wrcrooks/rtlplayground-modchip/docs/architecture.html

# RTLPlayground mod chip — architecture

An RP2350 board on the SWTG024AS switch's T3/T5/T8 headers takes over management from the RTL8372's built-in 8051, which keeps only what has to run on it.

## Your network

Browser
RTLPlayground web UI, Graphs dashboard — HTTP :80, HTTPS :443

SNMP manager
SNMPv2c :161, MIB-2 + IF-MIB per port

Syslog / NTP / DNS / DHCP
servers the switch talks to

Peers
STP / RSTP, LACP, LLDP, IGMP

Switch
ports

management
traffic via the
CPU port

## SWTG024AS switch RTL8372

Switch core
4 × 2.5G copper + 2 × 10G SFP+, VLANs, L2/ACL tables, counters — forwarding never leaves the ASIC

8051 + bridge firmware (RTLPlayground feat/modchip)

- chip init, forwarding defaults at boot
- SerDes modes on link / SFP changes
- CPU-port DMA: tunnels frames both ways
- PHY (MDIO), SerDes, SFP EEPROM, SPI flash on request
- batched table and counter reads

Without the mod chip, or if it stops, the switch keeps forwarding as configured.

T5 · UART0
~1 Mbaud

COBS + CRC-16 frames
one request in flight:
REG / PHY / SDS / SFP / FLASH
TBL_READ, STAT_READ
+ RX/TX frames, link and SFP events

T3 · I²C 0x5C

register access (planned)
+ 3.3 V power in

T8 · GPIO46–49

spare GPIO + 3.3 V power in

## Mod chip RP2350A 16 MiB flash

RTLPlayground modules
compiled unchanged: CLI, JSON pages, VLAN/port/L2, STP, LACP, IGMP, LLDP, DNS, NTP, syslog

Register HAL
reg / PHY / SDS / flash calls become bridge requests

lwIP
IPv4, ARP, DHCP, TCP/UDP on a netif over the bridge; management VLAN

Web server
HTTP + HTTPS (mbedTLS, TLS 1.2, key made on the device)

SNMP agent
read-only v2c, switch ports as interfaces

Graphs
10 s sampler, 1 h history in RAM, live charts

### Board

LM66100 ideal diode from the switch's 3.3 V · reset driver to the switch · SWD pads (flashing, RTT console) · 3.3 V sense keeps pins isolated until the switch is powered

github.com/wrcrooks/rtlplayground-modchip Not yet tested on hardware
