wrcrooks/rtlplayground-modchip/docs/architecture.png

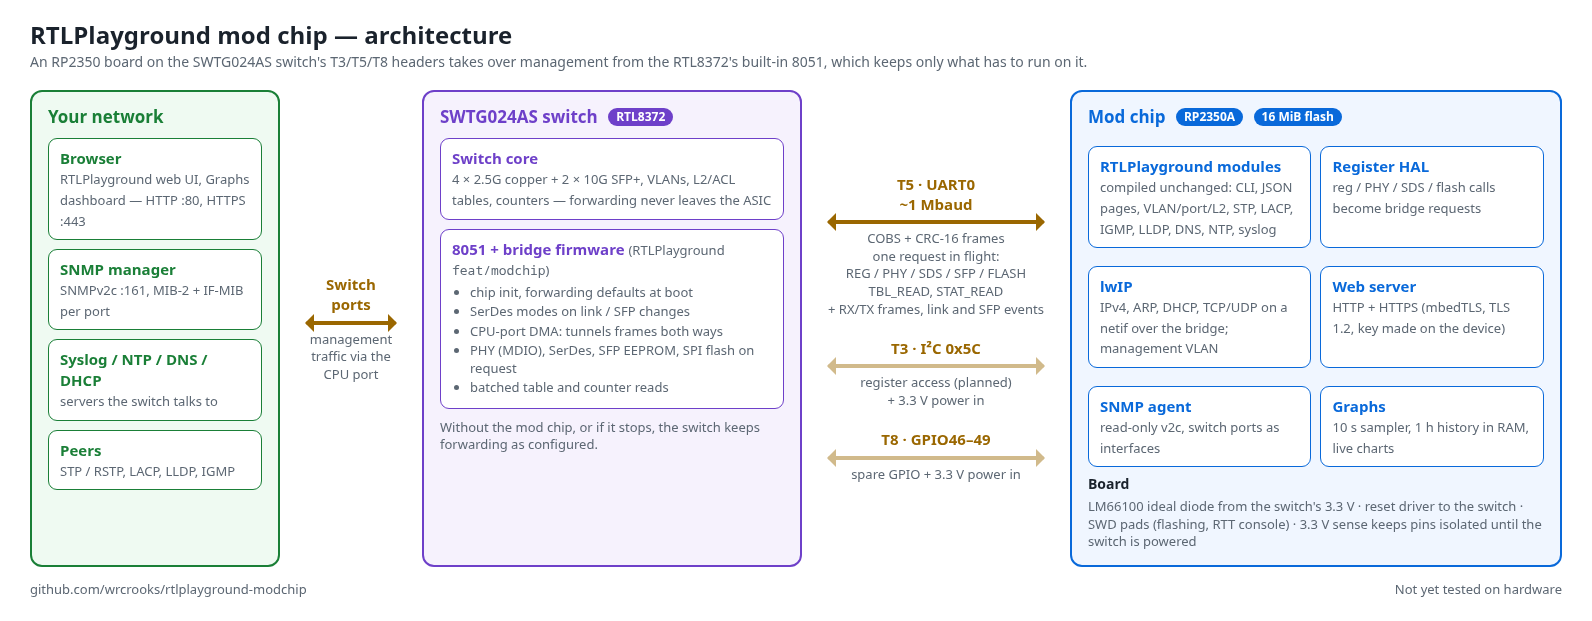
docs/architecture.png
