wrcrooks/rtlplayground-modchip/docs/pcb-3d.png

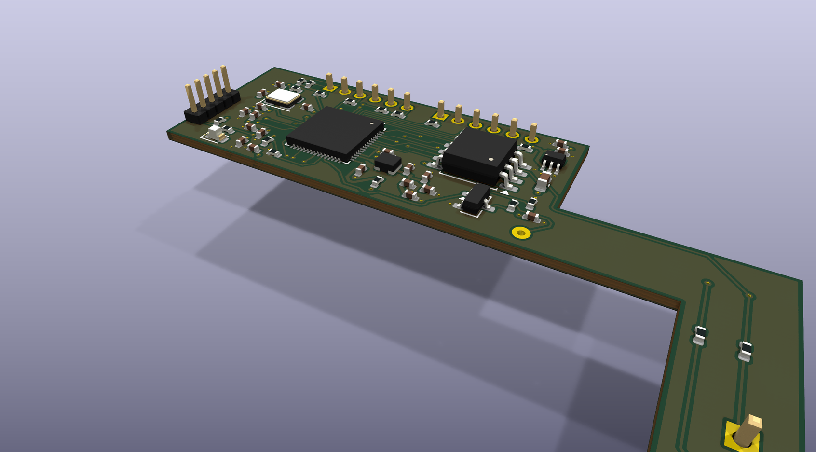
docs/pcb-3d.png
