wrcrooks/rtlplayground-modchip/hardware/overlay.jpg

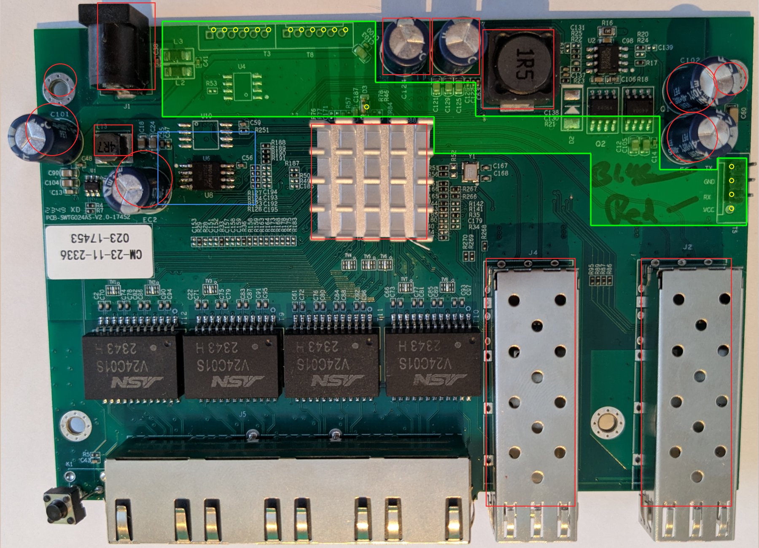
hardware/overlay.jpg
