wrcrooks/rtlplayground-modchip/hardware/production/bom.csv

Designator | Footprint | Quantity | Value | LCSC Part #
C1, C10, C11, C12, C19, C2, C3, C4, C5, C6, C7, C8, C9 | 0402 | 13 | 100n | C1525
C13, C14, C15, C16 | 0402 | 4 | 4.7u | C23733
C17, C18 | 0402 | 2 | 15p | C1548
C22 | 0603 | 1 | 10u | C19702
C24 | 0402 | 1 | 1u | C52923
D1 | 0603 | 1 | red | C2286
L1 | L_Murata_DFE201610P | 1 | 3.3uH | C42411119
Q1 | SOT-23 | 1 | 2N7002 | C8545
R10, R11, R12, R13, R14, R15, R16, R17, R18, R19 | 0402 | 10 | 100 | C25076
R20, R21 | 0402 | 2 | 4.7k | C25900
R22, R23, R24 | 0402 | 3 | 100k | C25741
R25, R6 | 0402 | 2 | 1k | C11702
R5 | 0402 | 1 | 33 | C25105
R8 | 0402 | 1 | 10k | C25744
R9 | 0402 | 1 | 330 | C25104
U1 | QFN-60-1EP_7x7mm_P0.4mm_EP3.4x3.4mm_ThermalVias | 1 | RP2350A | C42411118
U2 | SOT-363_SC-70-6 | 1 | LM66100 | C2869734
U5 | SOIC-8_5.3x5.3mm_P1.27mm | 1 | W25Q128JVSIQ | C97521
Y1 | Crystal_SMD_3225-4Pin_3.2x2.5mm | 1 | 12MHz | C20625731
