wrcrooks/rtlplayground-modchip/hardware/mechanical/modchip-no-headers.step

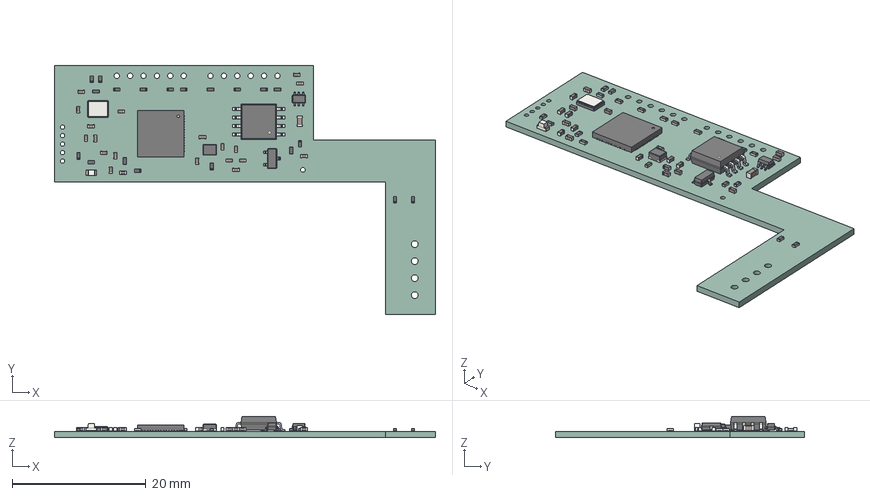
[picture p5: CAD file, 2026-10-25]
hardware/mechanical/modchip-no-headers.step
56.9 x 37.2 x 3.16 mm
C_0402_1005Metric x 20
C_0603_1608Metric
R_0402_1005Metric x 20
LED_0603_1608Metric
QFN-56-1EP_7x7mm_P0.4mm_EP3.2x3.2mm
SOT-23
L_Murata_DFE201610P
Crystal_SMD_3225-4Pin_3.2x2.5mm
SOIC-8_5.3x5.3mm_P1.27mm
SOT-363_SC-70-6
modchip_PCB
