wrcrooks/rtlplayground-modchip/hardware/modchip-outline.dxf

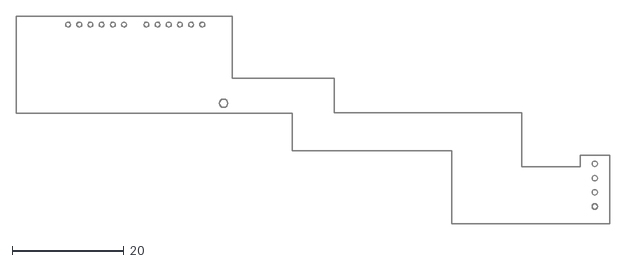
[picture p6: CAD file, 2026-10-22]
hardware/modchip-outline.dxf
106.2 x 37.2
