wrcrooks/rtlplayground-modchip/(list of files, cad)

Other CAD files:
hardware/mechanical/modchip-no-headers.stl
