wrcrooks/rtlplayground-modchip/hardware/modchip.kicad_pcb

## KiCad design hardware/modchip.kicad_pcb (2026-10-25)

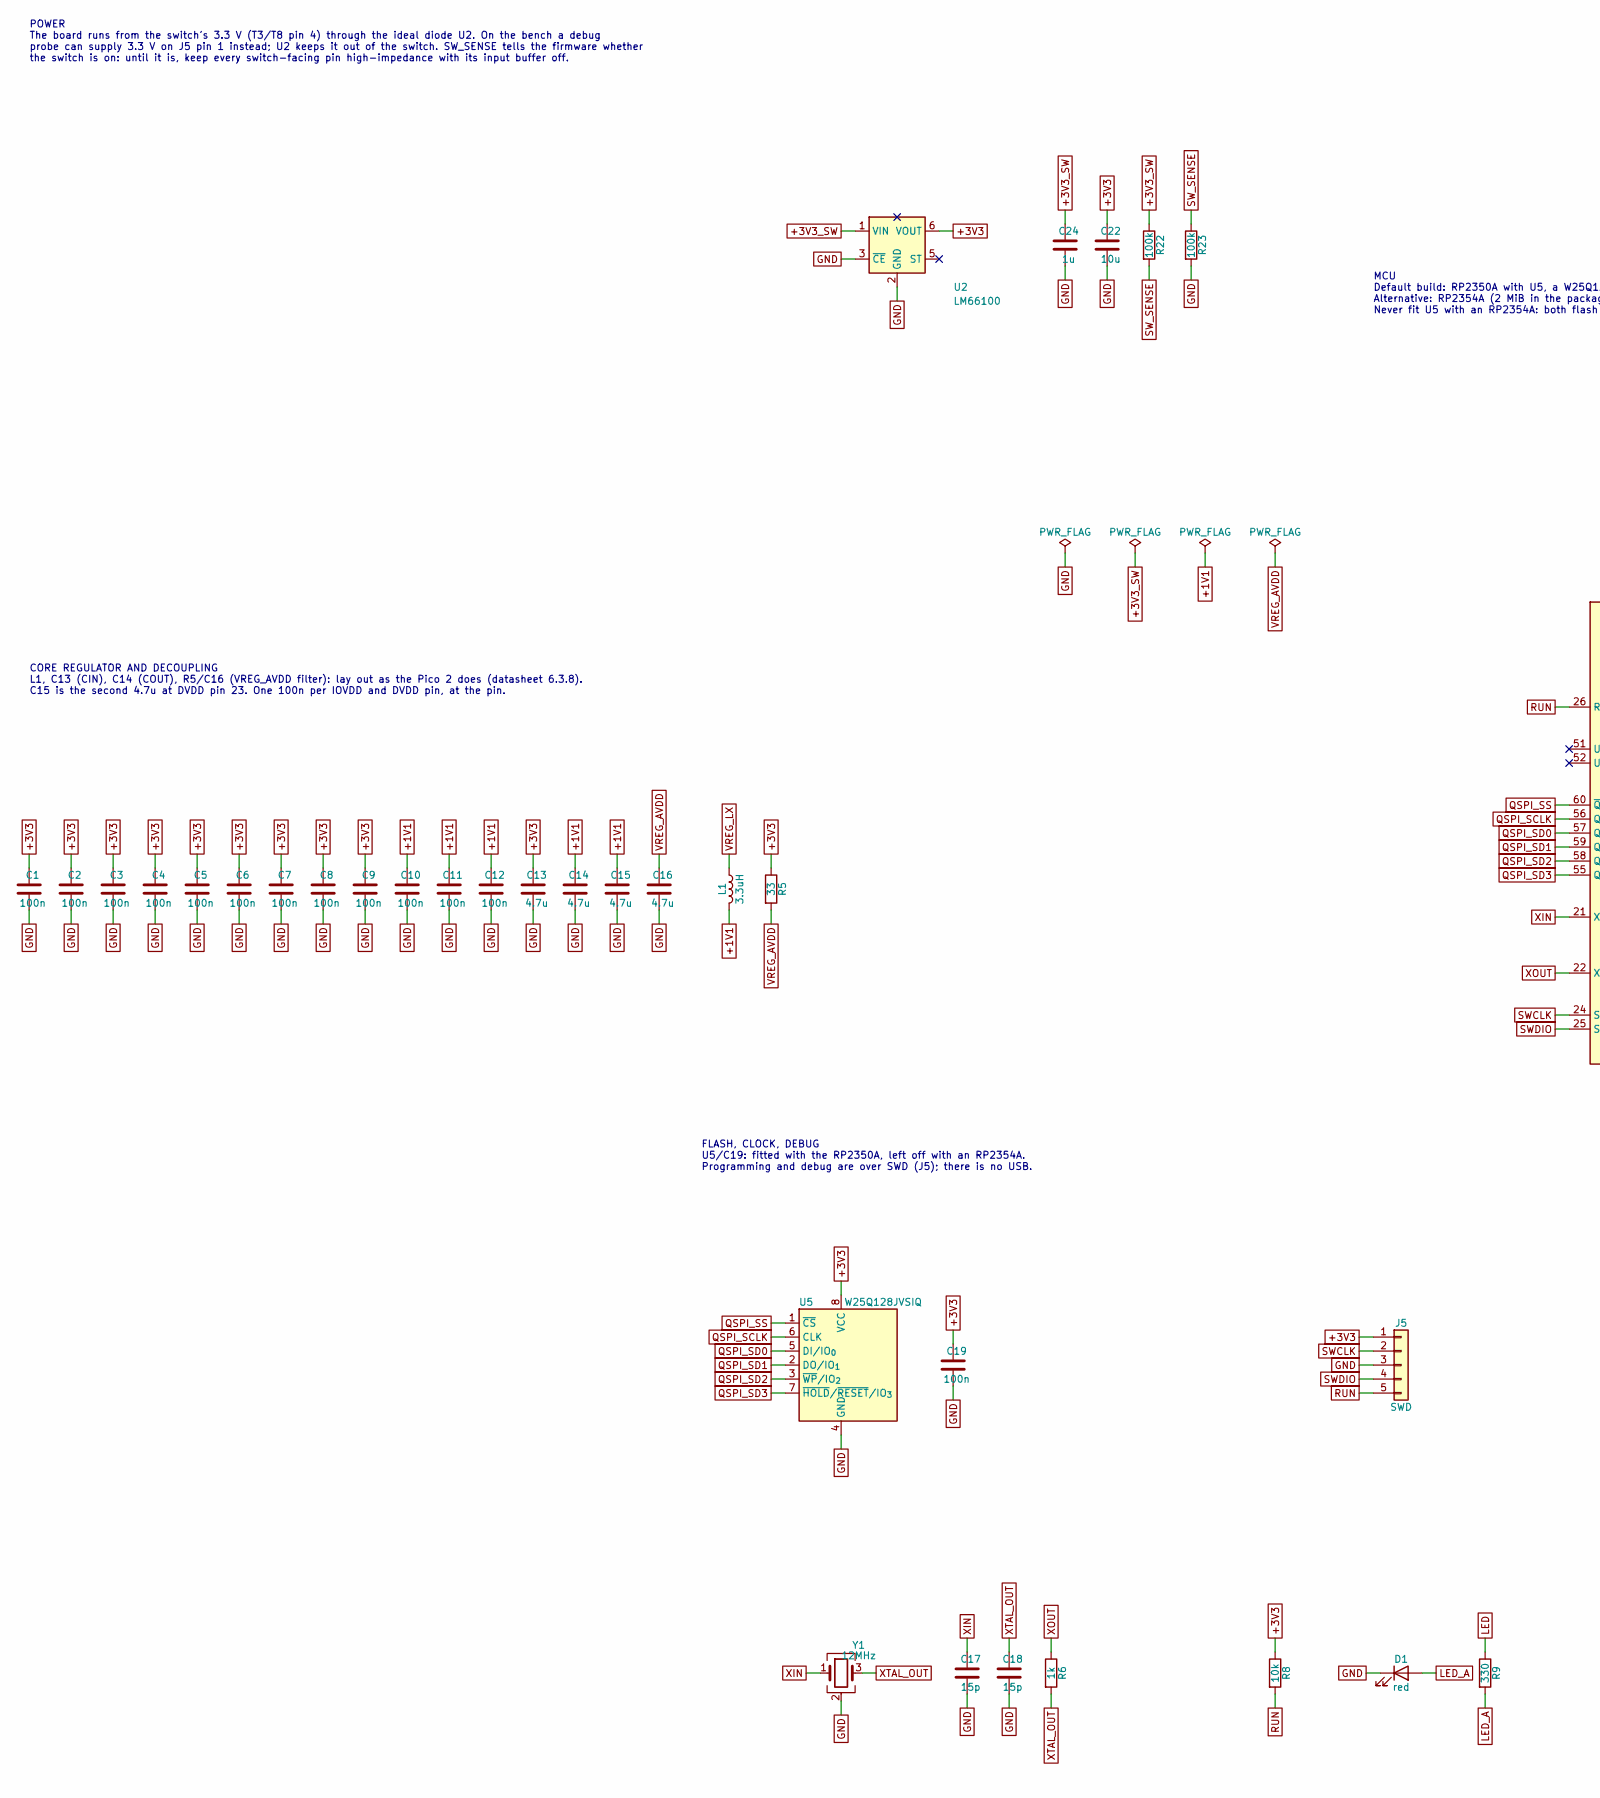
[picture p8: schematic modchip.kicad_sch, RTLPlayground mod chip (RP2350), part in row 1, column 1]

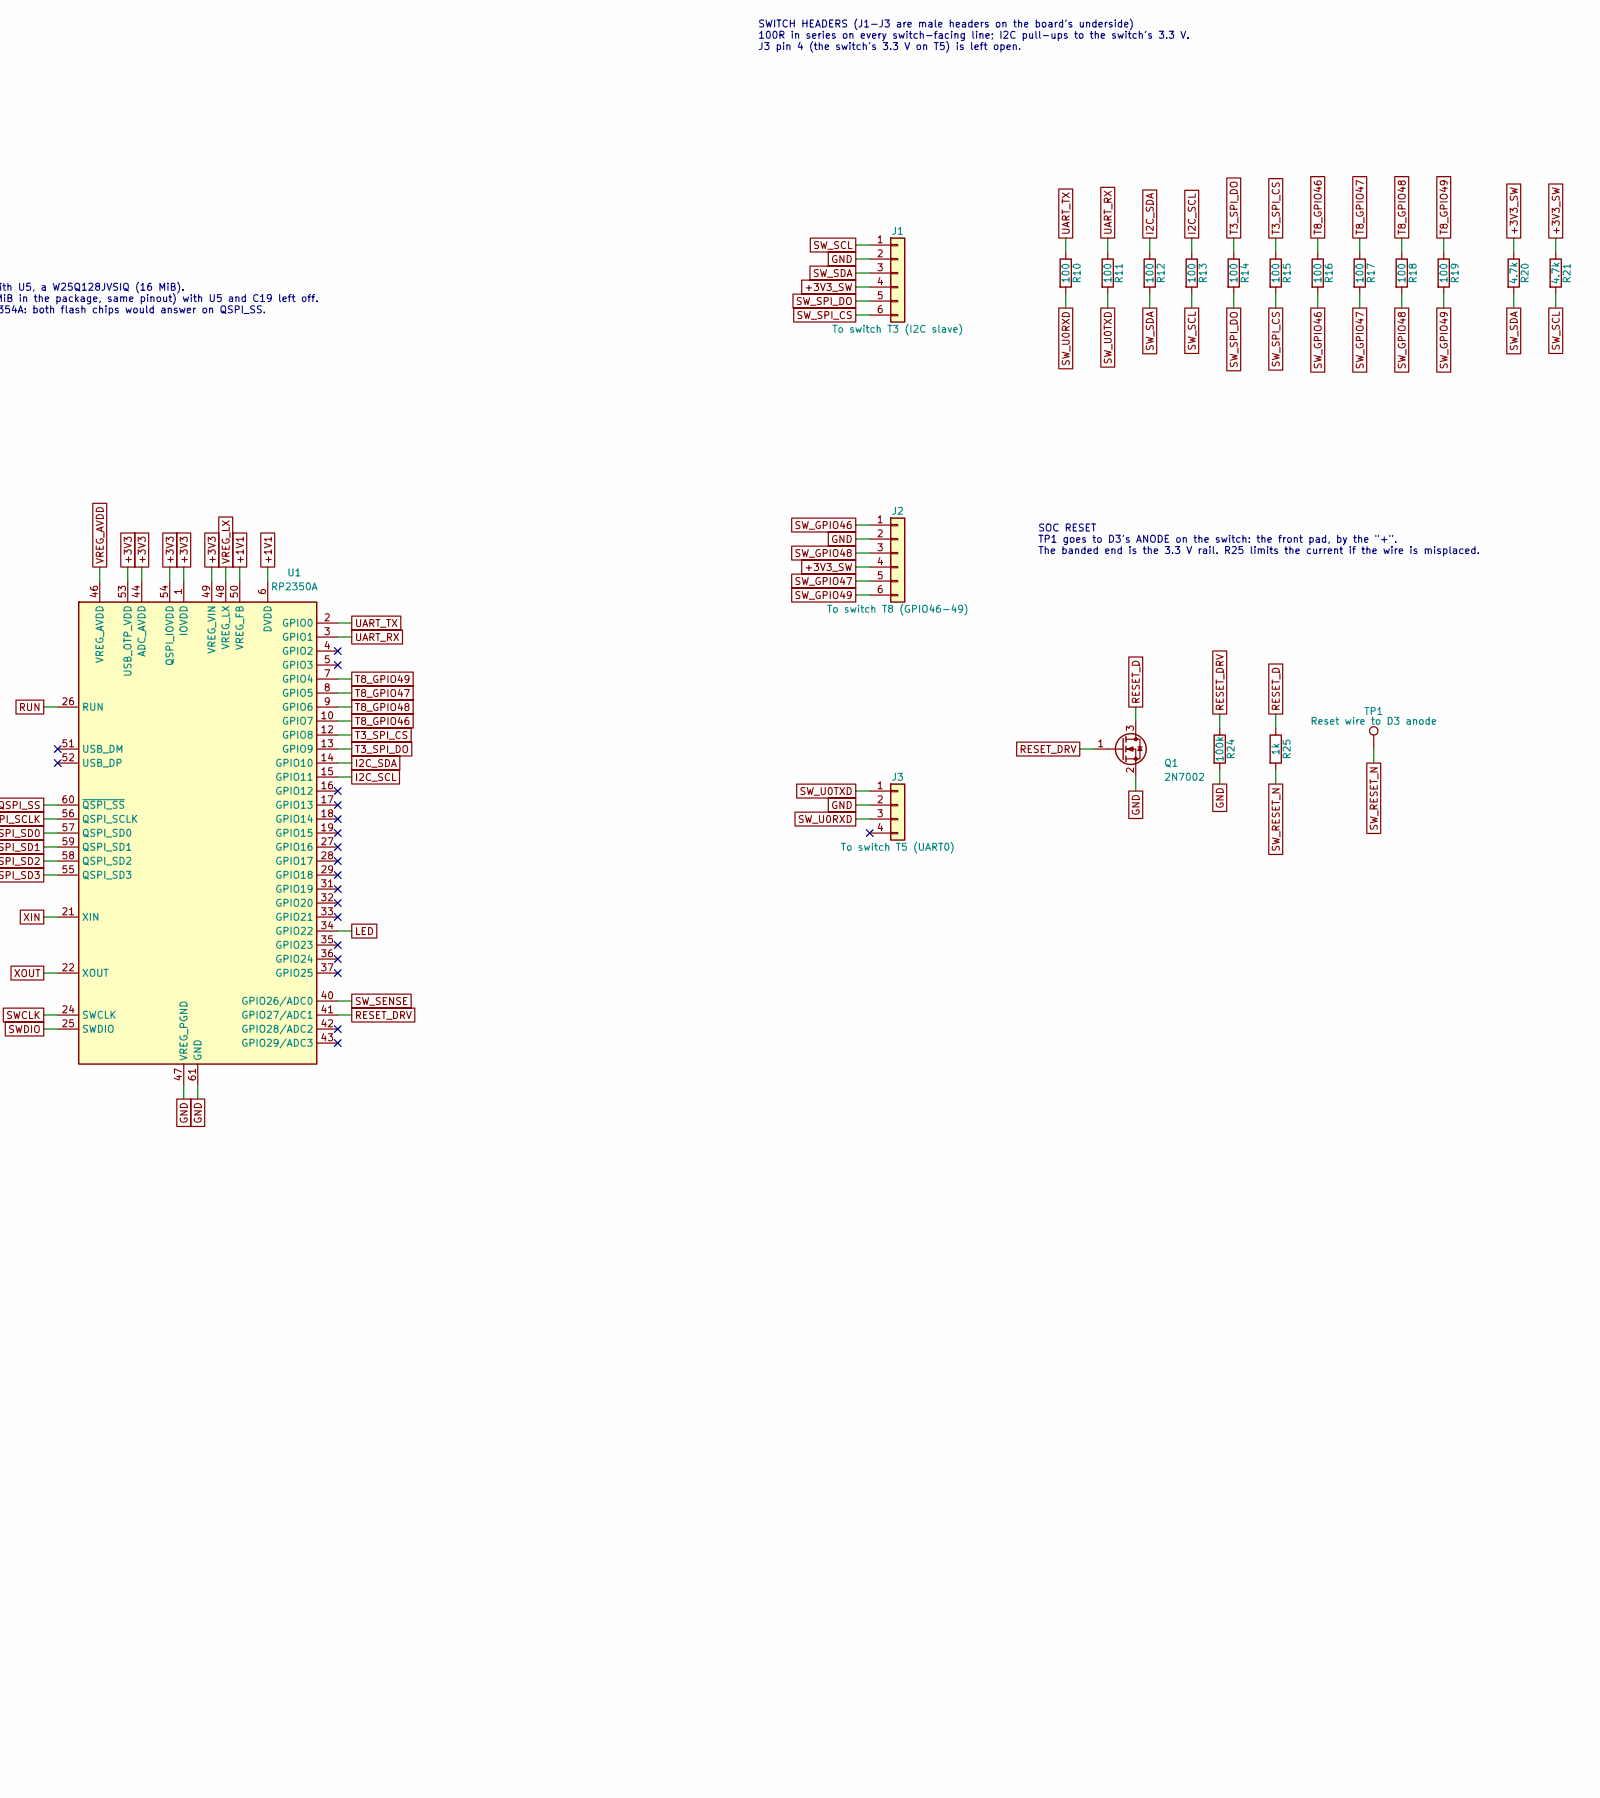
[picture p9: schematic modchip.kicad_sch, RTLPlayground mod chip (RP2350), part in row 1, column 2]

Parts:
C1, C2, C3, C4, C5, C6, C7, C8, C9, C10, C11, C12, C19: 100n; C_0402_1005Metric; LCSC C1525
C13, C14, C15, C16: 4.7u; C_0402_1005Metric; LCSC C23733
C17, C18: 15p; C_0402_1005Metric; LCSC C1548
C22: 10u; C_0603_1608Metric; LCSC C19702
C24: 1u; C_0402_1005Metric; LCSC C52923
D1: red; LED_0603_1608Metric; LCSC C2286
J1: To switch T3 (I2C slave); PinHeader_1x06_P2.00mm_Vertical
J2: To switch T8 (GPIO46-49); PinHeader_1x06_P2.00mm_Vertical
J3: To switch T5 (UART0); PinHeader_1x04_P2.54mm_Vertical
J5: SWD; PinHeader_1x05_P1.27mm_Vertical
L1: 3.3uH; L_Murata_DFE201610P; MPN Abracon AOTA-B201610S3R3-101-T, the dat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; LCSC C42411119
Q1: 2N7002; SOT-23; LCSC C8545
R5: 33; R_0402_1005Metric; LCSC C25105
R6, R25: 1k; R_0402_1005Metric; LCSC C11702
R8: 10k; R_0402_1005Metric; LCSC C25744
R9: 330; R_0402_1005Metric; LCSC C25104
R10, R11, R12, R13, R14, R15, R16, R17, R18, R19: 100; R_0402_1005Metric; LCSC C25076
R20, R21: 4.7k; R_0402_1005Metric; LCSC C25900
R22, R23, R24: 100k; R_0402_1005Metric; LCSC C25741
TP1: Reset wire to D3 anode; TestPoint_THTPad_D1.5mm_Drill0.7mm
U1: RP2350A; QFN-60-1EP_7x7mm_P0.4mm_EP3.4x3.4mm_ThermalVias; LCSC C42411118
U2: LM66100; SOT-363_SC-70-6; LCSC C2869734
U5: W25Q128JVSIQ; SOIC-8_5.3x5.3mm_P1.27mm; LCSC C97521
Y1: 12MHz; Crystal_SMD_3225-4Pin_3.2x2.5mm; MPN Abracon ABM8-272-T3: the RP2350 is tune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; LCSC C20625731

Connections:
+1V1: C10.1, C11.1, C12.1, C14.1, C15.1, L1.2, U1.6 (DVDD), U1.23 (DVDD), U1.39 (DVDD), U1.50 (VREG_FB)
+3V3: C1.1, C2.1, C3.1, C4.1, C5.1, C6.1, C7.1, C8.1, C9.1, C13.1, C19.1, C22.1, J5.1, R5.1, R8.1, U1.1 (IOVDD), U1.11 (IOVDD), U1.20 (IOVDD), U1.30 (IOVDD), U1.38 (IOVDD), U1.44 (ADC_AVDD), U1.45 (IOVDD), U1.49 (VREG_VIN), U1.53 (USB_OTP_VDD), U1.54 (QSPI_IOVDD), U2.6 (VOUT), U5.8 (VCC)
+3V3_SW: C24.1, J1.4, J2.4, R20.1, R21.1, R22.1, U2.1 (VIN)
GND: C1.2, C2.2, C3.2, C4.2, C5.2, C6.2, C7.2, C8.2, C9.2, C10.2, C11.2, C12.2, C13.2, C14.2, C15.2, C16.2, C17.2, C18.2, C19.2, C22.2, C24.2, D1.1 (K), J1.2, J2.2, J3.2, J5.3, Q1.2 (S), R23.2, R24.2, U1.47 (VREG_PGND), U1.61 (GND), U2.2 (GND), U2.3 (~CE), U5.4 (GND), Y1.2 (G), Y1.4 (G)
I2C_SCL: R13.1, U1.15 (GPIO11)
I2C_SDA: R12.1, U1.14 (GPIO10)
LED: R9.1, U1.34 (GPIO22)
LED_A: D1.2 (A), R9.2
QSPI_SCLK: U1.56 (QSPI_SCLK), U5.6 (CLK)
QSPI_SD0: U1.57 (QSPI_SD0), U5.5 (DI/IO_{0})
QSPI_SD1: U1.59 (QSPI_SD1), U5.2 (DO/IO_{1})
QSPI_SD2: U1.58 (QSPI_SD2), U5.3 (~WP/IO_{2})
QSPI_SD3: U1.55 (QSPI_SD3), U5.7 (~HOLD/~RESET/IO_{3})
QSPI_SS: U1.60 (~QSPI_SS), U5.1 (~CS)
RESET_D: Q1.3 (D), R25.1
RESET_DRV: Q1.1 (G), R24.1, U1.41 (GPIO27/ADC1)
RUN: J5.5, R8.2, U1.26 (RUN)
SWCLK: J5.2, U1.24 (SWCLK)
SWDIO: J5.4, U1.25 (SWDIO)
SW_GPIO46: J2.1, R16.2
SW_GPIO47: J2.5, R17.2
SW_GPIO48: J2.3, R18.2
SW_GPIO49: J2.6, R19.2
SW_RESET_N: R25.2, TP1.1
SW_SCL: J1.1, R13.2, R21.2
SW_SDA: J1.3, R12.2, R20.2
SW_SENSE: R22.2, R23.1, U1.40 (GPIO26/ADC0)
SW_SPI_CS: J1.6, R15.2
SW_SPI_DO: J1.5, R14.2
SW_U0RXD: J3.3, R10.2
SW_U0TXD: J3.1, R11.2
T3_SPI_CS: R15.1, U1.12 (GPIO8)
T3_SPI_DO: R14.1, U1.13 (GPIO9)
T8_GPIO46: R16.1, U1.10 (GPIO7)
T8_GPIO47: R17.1, U1.8 (GPIO5)
T8_GPIO48: R18.1, U1.9 (GPIO6)
T8_GPIO49: R19.1, U1.7 (GPIO4)
UART_RX: R11.1, U1.3 (GPIO1)
UART_TX: R10.1, U1.2 (GPIO0)
VREG_AVDD: C16.1, R5.2, U1.46 (VREG_AVDD)
VREG_LX: L1.1, U1.48 (VREG_LX)
XIN: C17.1, U1.21 (XIN), Y1.1
XOUT: R6.1, U1.22 (XOUT)
XTAL_OUT: C18.1, R6.2, Y1.3

Notes on the sheet:
POWER The board runs from the switch's 3.3 V (T3/T8 pin 4) through the ideal diode U2. On the bench a debug probe can supply 3.3 V on J5 pin 1 instead; U2 keeps it out of the switch. SW_SENSE tells the firmware whether the switch is on: until it is, keep every switch-facing pin high-impedance with 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
MCU Default build: RP2350A with U5, a W25Q128JVSIQ (16 MiB). Alternative: RP2354A (2 MiB in the package, same pinout) with U5 and C19 left off. Never fit U5 with an RP2354A: both flash chips would answer on QSPI_SS.
SOC RESET TP1 goes to D3's ANODE on the switch: the front pad, by the "+". The banded end is the 3.3 V rail. R25 limits the current if the wire is misplaced.
FLASH, CLOCK, DEBUG U5/C19: fitted with the RP2350A, left off with an RP2354A. Programming and debug are over SWD (J5); there is no USB.
SWITCH HEADERS (J1-J3 are male headers on the board's underside) 100R in series on every switch-facing line; I2C pull-ups to the switch's 3.3 V. J3 pin 4 (the switch's 3.3 V on T5) is left open.
CORE REGULATOR AND DECOUPLING L1, C13 (CIN), C14 (COUT), R5/C16 (VREG_AVDD filter): lay out as the Pico 2 does (datasheet 6.3.8). C15 is the second 4.7u at DVDD pin 23. One 100n per IOVDD and DVDD pin, at the pin.

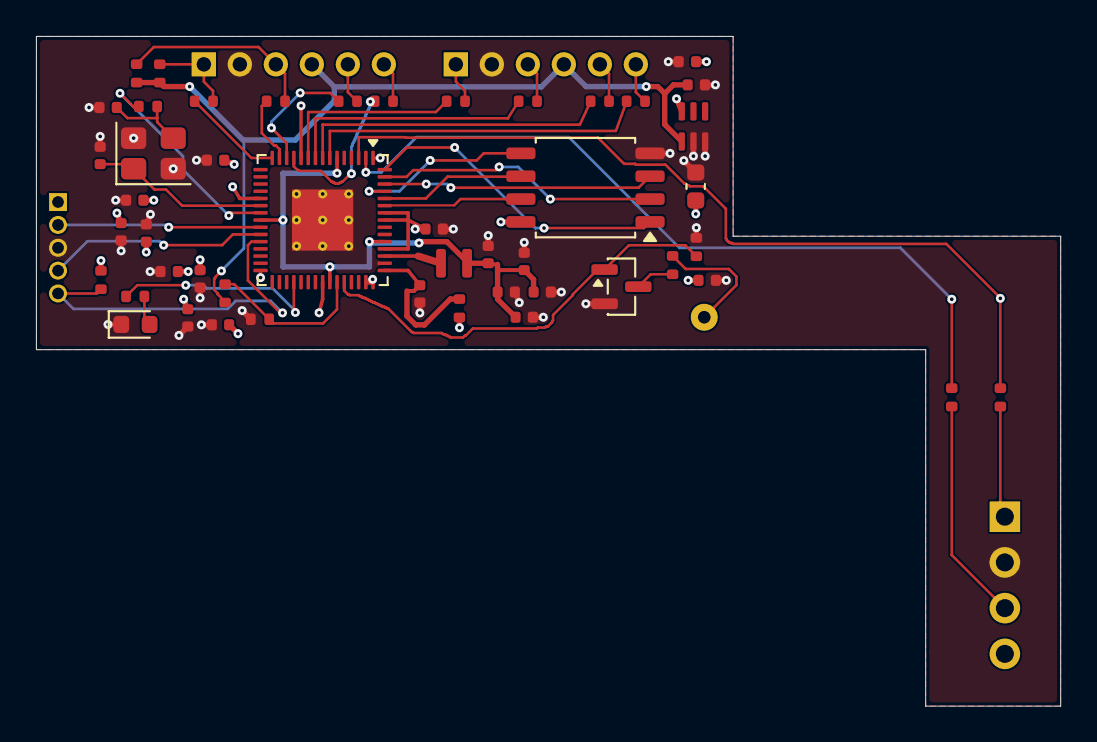
[picture p10: board modchip.kicad_pcb from above]

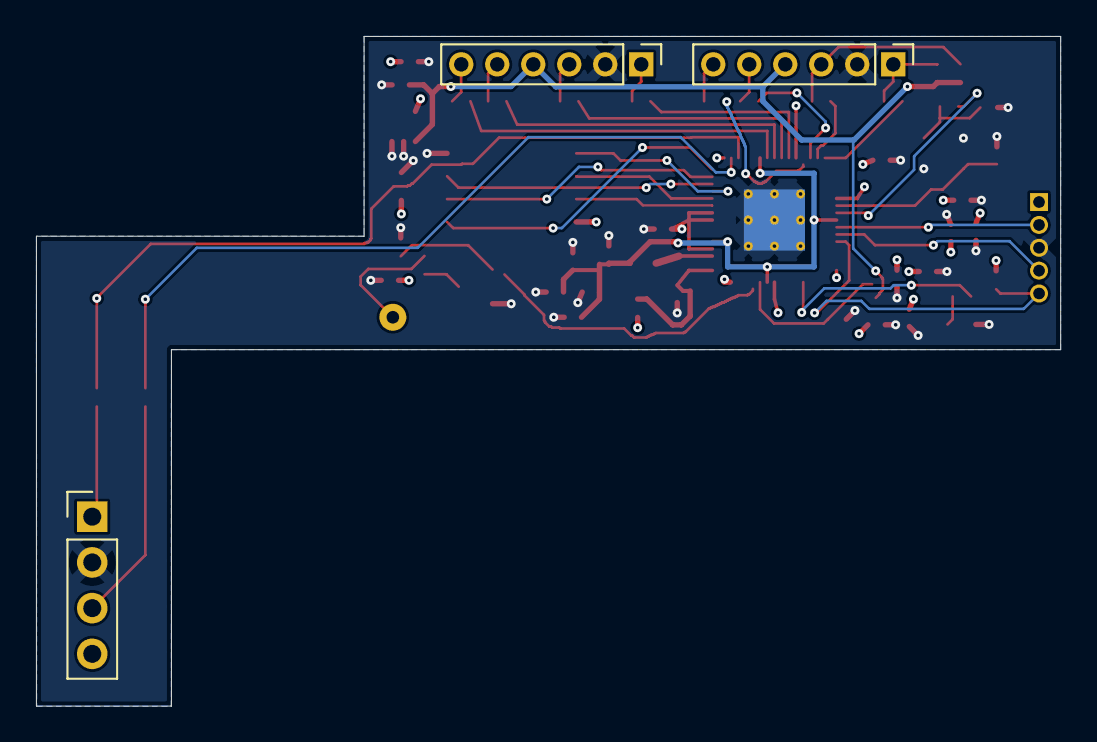
[picture p11: board modchip.kicad_pcb from below]

Board: 4 copper layers, 56.9 x 37.2 mm, 53 parts (3 on the bottom side), 44 nets.
