wrcrooks/rtlplayground-modchip/firmware/rp2350/src/net.h

#ifndef _NET_H_
#define _NET_H_

#include <stdbool.h>
#include <stdint.h>

void net_init(void);
void net_up(void);
void net_down(void);
void net_input(uint8_t *frame, uint16_t len);
void net_poll(void);		/* each main loop pass */
void net_udp_poll(void);	/* each tick */
void net_second(void);

void httpd_init(void);
void httpd_second(void);
bool httpd_poll(void);		/* each main loop pass; true if it did something */
struct altcp_tls_config;
bool httpd_tls_start(struct altcp_tls_config *conf);
void httpd_tls_stop(void);

void snmp_second(void);

void t3_power(bool on);		/* the T3 bus, with the switch's power */

#endif
