wrcrooks/rtlplayground-modchip/firmware/rp2350/src/snmp_udp.c

/*
 * The agent's UDP socket on lwIP, in place of lwIP's snmp_raw.c, so that
 * "snmp off" can close port 161 again.
 */

#include "lwip/apps/snmp.h"
#include "lwip/ip.h"
#include "lwip/udp.h"

#include "snmp_modchip.h"

/* lwIP's SNMP core, from snmp_msg.h and snmp_traps.c */
void snmp_receive(void *handle, struct pbuf *p, const ip_addr_t *source_ip, u16_t port);
extern void *snmp_traps_handle;

static struct udp_pcb *pcb;

static void snmp_recv(void *arg, struct udp_pcb *upcb, struct pbuf *p, const ip_addr_t *addr, u16_t port)
{
	(void)arg;
	snmp_receive(upcb, p, addr, port);
	pbuf_free(p);
}


err_t snmp_sendto(void *handle, struct pbuf *p, const ip_addr_t *dst, u16_t port)
{
	return udp_sendto((struct udp_pcb *)handle, p, dst, port);
}


u8_t snmp_get_local_ip_for_dst(void *handle, const ip_addr_t *dst, ip_addr_t *result)
{
	struct udp_pcb *upcb = handle;
	struct netif *dst_if;
	const ip_addr_t *dst_ip;

	(void)upcb;
	ip_route_get_local_ip(&upcb->local_ip, dst, dst_if, dst_ip);
	if (dst_if && dst_ip) {
		ip_addr_copy(*result, *dst_ip);
		return 1;
	}
	return 0;
}


bool snmp_transport_open(void)
{
	if (pcb)
		return true;
	pcb = udp_new_ip_type(IPADDR_TYPE_ANY);
	if (!pcb)
		return false;
	udp_recv(pcb, snmp_recv, NULL);
	if (udp_bind(pcb, IP_ANY_TYPE, 161) != ERR_OK) {
		udp_remove(pcb);
		pcb = NULL;
		return false;
	}
	snmp_traps_handle = pcb;
	return true;
}


void snmp_transport_close(void)
{
	if (!pcb)
		return;
	udp_remove(pcb);
	pcb = NULL;
	snmp_traps_handle = NULL;
}


bool snmp_transport_is_open(void)
{
	return pcb != NULL;
}
