wrcrooks/rtlplayground-modchip/(commit log)

2026-10-22 modchip: bridge firmware for an RP2040 management board
    An RP2040 on headers T3 (slave interface) and T5 (UART) takes over the
    management plane. The 8051 runs a minimal bridge firmware: it initialises
    the switch to RTLPlayground's forwarding defaults, keeps the SerDes and SFP
    slots working, tunnels CPU-port frames over the UART and runs the
    operations only it can reach (PHY, SerDes, SFP EEPROM, flash) on request.
    - modchip/bridge: the firmware, linked with the shared chip-level modules
    (about 34 KB of code). hal.c copies RTLPlayground's helpers unchanged;
    check_hal.py reports drift. A separate Makefile builds it.
    - modchip/bridge/link.c: COBS framing with CRC-16/MODBUS, compiled
    uncha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
    [bridge.c, bridge.h, bridge_host_test.py, bridge_link.py, link.c, link.h, read_chip_id.py]
2026-10-22 modchip: board outline reaching T3, T8 and T5
    hardware/outline.py holds the outline, the header holes and the parts to
    avoid, checks the clearances, and writes a DXF for KiCad (origin T3 pin 1),
    a 1:1 SVG template to lay on the switch and an overlay on the board photo.
    The outline keeps at least 1.3 mm from every through-hole or tall part and
    leaves room for a test clip on the SPI flash U8.
    Recalibrated on U8's 1.27 mm pin pitch, the photo shows T3 and T8 as 2.0 mm
    pitch headers, not 2.54 mm, on a board about 131 x 95 mm; ARCHITECTURE.md
    had the dimensions about 27 % too large and is corrected.
    Claude-Session: https://claude.ai/code/s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
    [modchip-outline.dxf]
2026-10-22 modchip: check the outline against a managed board's photo
    outline.py takes a calibration per photo (scale, origin, rotation) and now
    also draws the outline on up-n-atom's SWTG024AS-v2 managed board photo,
    calibrated independently on U8's and T3's pin pitches. Every part to avoid
    lands inside its footprint there; the header holes agree with the model to
    within about 0.8 mm. Overlay line widths scale with the photo.
    Claude-Session: https://claude.ai/code/session_015H5zFJRMkAr91cV6L5o8Yv
    [outline.py]
2026-10-22 modchip: hardware README: the hole offset is towards the front
    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
2026-10-22 modchip: remeasure the board outline on the near-flat photo
    The model is now measured on up-n-atom's managed SWTG024AS-V2.0 photo,
    which is taken almost straight down (38.3 px/mm on U8's and T3's pin
    pitches, about +/-0.3 mm). Against the angled photo it corrects the
    board's depth (88.7 mm, not 95), moves the heatsink 1.6 mm forward and
    the header holes by up to 0.8 mm, and adds the rear-right standoff.
    The outline is redrawn to the new positions: at least 1.3 mm from every
    through-hole or tall part, 2.7 mm from U8's clip zone, and every header
    hole and the reset pad at least 1.5 mm inside the edge. The unmanaged
    photo stays as a cross-check.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
    [modchip-outline.dxf]
2026-10-22 modchip: KiCad 10 board with the outline and header footprints
    make_pcb.py builds modchip.kicad_pcb from outline.py with KiCad's Python
    API: the outline on Edge.Cuts, KiCad's 2.0 mm and 2.54 mm pin headers on the
    bottom side on the T3, T8 and T5 holes (every pad within 0.001 mm of its
    hole after a reload), a through-hole pad above D3 for the reset wire, the
    switch's parts on Dwgs.User and U8's clip zone on Cmts.User, with the aux
    and grid origins at T3 pin 1. Pads carry the names of the switch signals
    they reach. DRC: no violations; the only unconnected items are the shared
    GND and +3V3_SW pins. Saved by KiCad 10.0.5.
    Claude-Session: h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
    [modchip.kicad_pcb]
2026-10-22 modchip: switch to the RP2350; wire the reset to D3's anode
    The design moves from the RP2040 to the RP2350 (RP2354A, with 2 MiB of flash
    in the package, or RP2350A with a W25Q16JV): a hardware RNG, SHA-256
    acceleration, OTP for keys and 520 KB of SRAM make HTTPS practical. The
    architecture doc covers the on-chip switching regulator's inductor, the
    four-layer stack, erratum E9 and the UART divisors from a 150 MHz clk_peri.
    Pin assignments are unchanged; the Pico scripts run on a Pico 2 as well.
    The doc placed the reset line at D3's cathode. In this RC reset the
    cathode (the banded rear end) sits on the 3.3 V rail, and pulling it low
    would short the supply. The reset node is the anode, the fr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
    [modchip-outline.dxf, modchip.kicad_pcb]
2026-10-22 modchip: KiCad 10 schematic of the RP2350 mod chip
    make_sch.py generates modchip.kicad_sch from tables that give the net of
    every pin of every part, with symbols from KiCad 10's standard library
    (flattened as KiCad embeds them) and global labels named as on the board.
    check_sch.py runs ERC and compares KiCad's netlist pin by pin with
    expected-nets.json: all 240 pins match, and the only ERC error is the
    intended one, the two LM66100 ideal diodes both driving +3V3.
    The circuit: RP2354A with the core regulator from the datasheet's figure
    22, a 12 MHz crystal, BOOTSEL/RUN, SWD and a status LED; USB-C with ESD
    protection and an AP2112K-3.3, ORed with the switch's 3.3 V by two
    LM66100; a sense di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
    [modchip.kicad_pcb, modchip.kicad_sch]
2026-10-22 modchip: route the RP2350 board and generate JLCPCB production files
    Layout and routing, built by modchip/hardware/build.sh with kicad-agent-kit
    (board from netlist, placement, plane fanout, Freerouting, A* finisher):
    - 4 layers: F.Cu parts and signals, In1 GND, In2 +3V3, B.Cu signals; only
    the hand-soldered headers on the bottom.
    - GPIOs follow the board: U1 rotated 270 puts GP11..GP0 under T3/T8 in
    header order (I2C on I2C1, GP11/GP10; T8 on GP7..GP4; UART GP0/GP1;
    reset GP27; LED GP22), so the fan-out doesn't cross.
    - Hand routes laid before the router: VREG_LX and VREG_AVDD, the +3V3 trunk
    to CIN, the +1V1 DVDD pins on vias and B.Cu tracks round the exposed pad,
    the T8 fan and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
    [bom.csv, designators.csv, modchip.kicad_pcb, modchip.kicad_sch, positions.csv]
2026-10-22 modchip: STL and STEP of the board without headers, for a printed fit check
    KiCad 10 export of the board and the assembled parts (J1-J3, J5 and TP1 left
    out), origin at T3 pin 1, underside at z = 0 so it prints flat. U1 uses the
    QFN-56 7x7 mm model (same body; the library has no QFN-60 model) in a
    scratch copy. build.sh regenerates both.
    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
    [modchip-no-headers.step, modchip-no-headers.stl]
2026-10-22 Move the mod chip into its own repository
    The mod chip work started in wrcrooks/RTLPlayground (branch feat/modchip,
    directory modchip/); this history is that directory's, split out. Here it
    keeps the hardware (KiCad schematic and board, outline, STL/STEP, JLCPCB
    files), the RP2350-side MicroPython tools and the design document. The 8051
    bridge firmware stays in RTLPlayground, where it shares the chip-level
    modules; links point there.
    - pico/ moves to firmware/micropython/.
    - The protocol cross-check moves here as test_bridge_link.py, against
    golden frames from the bridge's link.c (bridge_vectors.txt, produced by
    RTLPlayground's test_bridge_link --emit).
    - Paths and title blocks follow t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
2026-10-22 hardware: title blocks name the new repository
    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
    [modchip.kicad_pcb, modchip.kicad_sch]
2026-10-22 README: status: not tested yet, awaiting the assembled PCBs
    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
2026-10-23 firmware/rp2350: RP2350 application firmware
    Takes over what RTLPlayground's 8051 firmware did above the chip level:
    web UI with its JSON endpoints, command line, lwIP with DHCP, DNS, NTP,
    syslog, STP/LACP/IGMP/LLDP and the configuration. RTLPlayground's
    portable modules compile unchanged from a submodule (wrcrooks/RTLPlayground
    feat/modchip) with its host-test shim; register, PHY, SerDes, SFP and
    flash access become bridge requests over T5.
    Host tests: the framing against the bridge's own frames, and the
    RTLPlayground half against a simulated bridge. Not yet run on hardware.
    Claude-Session: https://claude.ai/code/session_015H5zFJRMkA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
2026-10-23 firmware/rp2350: table reads, SerDes and flash ID via the bridge; HTTPS; SNMP
    - The register HAL sends a table read command as one TBL_READ and answers
    the poll and result reads from its reply; VLAN entries come 64 at a
    time. /vlanlist: 64 bridge requests instead of 12282.
    - sds_config() goes to the 8051 as SDS_CONFIG; a speed forced with
    "sfp <slot> <speed>" is applied that way, also on later insertions.
    - "flash j|u|s" print what the 8051's own dump functions print (FLASH_ID).
    - HTTPS: TLS 1.2 on port 443 next to HTTP, on lwIP's altcp with mbedTLS;
    an ECDSA P-256 key and self-signed certificate made on the device and
    kept in flash. "https on|off|newcert".
    - SNMP: read-only SNMPv2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
2026-10-23 firmware/rp2350: graphs dashboard
    A dashboard page (Graphs in the web UI's menu) with animated canvas charts
    and an hour of history: per-port and total traffic, packets by type,
    errors and discards, a link speed timeline with changes, switch, mod chip
    and SFP temperatures, SFP optics, MAC table size, mod chip load and heap,
    bridge link load and health, STP/LACP/IGMP activity.
    - metrics.c samples every 10 s into a RAM ring and serves /metrics.json
    and /history.bin; rtl_metrics.c reads the switch, all ports' counters
    in one STAT_READ (submodule now at 684ab8e).
    - TLS session cache, so HTTPS polling resumes instead of renegotiating.
    - tools/dashboard_preview.py serves the page with simulat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
    [bridge.c, bridge.h, bridge_link.py, httpd.c, lwipopts.h, main.c]
2026-10-23 dashboard: port charts by top speed; no Links card
    Ports with the same top speed share one chart, their in and out lines
    overlaid (2.5 Gb/s copper ports 1-4, 10 Gb/s SFP+ ports 5-6 on the
    SWTG024AS), each port's current state - link speed, down or off - in its
    legend entry. The Links card (speed timeline and change list) is gone.
    /metrics.json gives each port's top speed ("max").
    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
2026-10-23 dashboard: Title Case for chart titles, legends and keys
    Card and chart titles, legend and tooltip labels, tile keys, table
    headers and the state badges (Up, Down, Off). The grey subtitles stay
    sentence case, and port names as configured.
    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
2026-10-23 docs: 3D render of the board and an architecture overview
    docs/pcb-3d.png is KiCad 10's render of hardware/modchip.kicad_pcb (the
    RP2350 drawn with the QFN-56 stand-in body build.sh uses for STEP).
    docs/architecture.png is rendered from docs/architecture.html.
    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
2026-10-23 firmware/rp2350: Beetle RP2350 build target and test-rig wiring
    -DMODCHIP_BOARD=beetle builds the firmware for a DFRobot Beetle RP2350
    wired to the switch as a stand-in for the mod chip until the boards
    arrive: same RP2350A and pins for the bridge UART, 3.3 V sense and reset
    driver; 2 MiB flash; USB serial console instead of RTT. The default
    build is unchanged.
    docs/beetle-test-rig.md: parts, wiring (UART, sense divider, optional
    reset transistor to D3's anode), flashing the bridge, MicroPython checks,
    building and flashing the firmware, what the console should show.
    Claude-Session: https://claude.ai/code/session_015H5zFJRMkAr91cV6L5o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
    [modchip_beetle.h]
2026-10-23 firmware/rp2350: switch firmware updates from the web UI; fix header lookup
    /upload now does what RTLPlayground's does, through the bridge: the
    multipart image streams into the bridge's staging area (FLASH_ERASE /
    FLASH_WRITE), one flash operation per main loop pass with TCP flow
    control holding the browser back, is read back and CRC-checked, and is
    answered "OK: checksum verified, rebooting" before the bridge reboots to
    install it. Any image in the bridge's layout with a valid CRC that
    starts 00 40 goes: a new bridge build, or RTLPlayground to go back,
    without the CH341A. Failures and aborted uploads erase the first staging
    sector so nothing installable stays behind; refusals wait for the w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
    [httpd.c, lwipopts.h, main.c, net.h, upload.c]
2026-10-23 firmware/rp2350: register access over T3 (I2C), off until enabled
    t3.c drives the RTL8372's slave interface at 0x5c: reads as a 2-byte
    register address then a repeated-start 4-byte read; writes as one plain
    6-byte transfer (address high byte first, value low byte first), the
    format vDorst/rtl-rs uses against the same interface. The bus comes up
    with the switch's power, like the bridge UART.
    t3_route.c decides: "t3 on [100|400|1000]" moves plain register reads
    and writes onto T3, TBL_READ and STAT_READ stay on the bridge, a failed
    transfer falls back to the bridge, and 10 failures in a row turn T3 off.
    "t3 test" is bring-up step 2: chip ID over both paths, and a write to
    the seconds-counter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
    [main.c, metrics.c, net.h, plat.h, rtl_env.c, rtl_ext.c]
2026-10-24 Bridge link diagnostics; T3 test on a writable register
    First bring-up on hardware (Beetle rig, MokerLink): the bridge now answers
    HELLO, the mod chip serves the web UI and dashboard at its configured IP,
    and "t3 test" passes, writes included, so the write format from rtl-rs
    holds on the RTL8372. T3 at 400 kHz runs without errors.
    - Console commands for a bridge that doesn't answer: "bridge" (link state
    and UART counters), "bridge log" (the 8051's last 2 KiB of output, which
    it prints before a console is open), "bridge raw" (the first 4 KiB after
    power-up), "bridge probe" (idle level and edges on GP0/GP1) and
    "bridge hold on|off" (only listen). They found the two bridge bugs fixed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
    [bridge.c, bridge.h, main.c, plat.h, rtl_ext.c]
2026-10-25 HTTPS switch in System > Services; fix the panic on "https off"
    - Web UI: embed_web.py adds an HTTPS switch to RTLPlayground's System page.
    It shows the running state (from "https"), the certificate's SHA-256
    fingerprint and a link to the HTTPS address, asks before turning HTTPS
    off from a page opened over HTTPS, and is translated like the rest of
    the page.
    - Save to flash: the web UI keeps only the commands its CONF_CMDS list
    knows, so "https", "snmp" and "t3" were dropped from the saved config.
    The same script adds them, with the merge rules for each.
    test/check_conf_merge.js runs the submodule's mergeConf() with them.
    - httpd_tls_stop(): closing the TLS listener panicked the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
    [httpd.c, lwipopts.h]
2026-10-25 Watchdog; version from git on every build
    - Watchdog: 8 s, fed by the main loop and by the waits with their own
    time limits (plat_delay_ms(), a bridge request's reply), so a slow or
    silent 8051 never sets it off. A panic, a hard fault or a loop that
    never returns now restarts the RP2350 instead of needing the reset
    button. A watchdog restart shows in /metrics.json ("watchdog_reset"),
    as "Last Restart" on the dashboard's Mod Chip card and on the console.
    "watchdog test" stops the main loop to check it on the hardware.
    - Version: tools/version.cmake runs "git describe --dirty" on every build
    (a custom target), not only when CMake configures, so the firmware no
    longer reports th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
    [bridge.c, main.c, metrics.c, metrics.h, plat.h, rtl_ext.c]
2026-10-25 hardware: shorter T5 tail; production files, STL/STEP and render
    The board, edited in KiCad: the tail ends about 50 mm short of T5, so the
    outline is 56.95 x 37.25 mm (was 106.25 x 37.25), J3 sits at (44.5, 25.1)
    mm from T3 pin 1 instead of on T5 (94.2, 24.9) and reaches T5 with a
    harness, and R10/R11 moved next to it. The schematic, nets and the other
    50 footprints are unchanged.
    Exported from that board as saved (the scripts' placement and routing
    steps not run, which would rebuild the old layout):
    - production/: Gerbers and drills (zones refilled: the In1/In2 pours'
    outlines still span the old width, the fills stop 0.3 mm inside the new
    edge), BOM (unchanged), positions (R10 and R11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
    [modchip-no-headers.step, modchip-no-headers.stl, modchip.kicad_pcb, positions.csv]
